alexc0888/Digital-Audio-Effects-Player/Project Schem.pdf

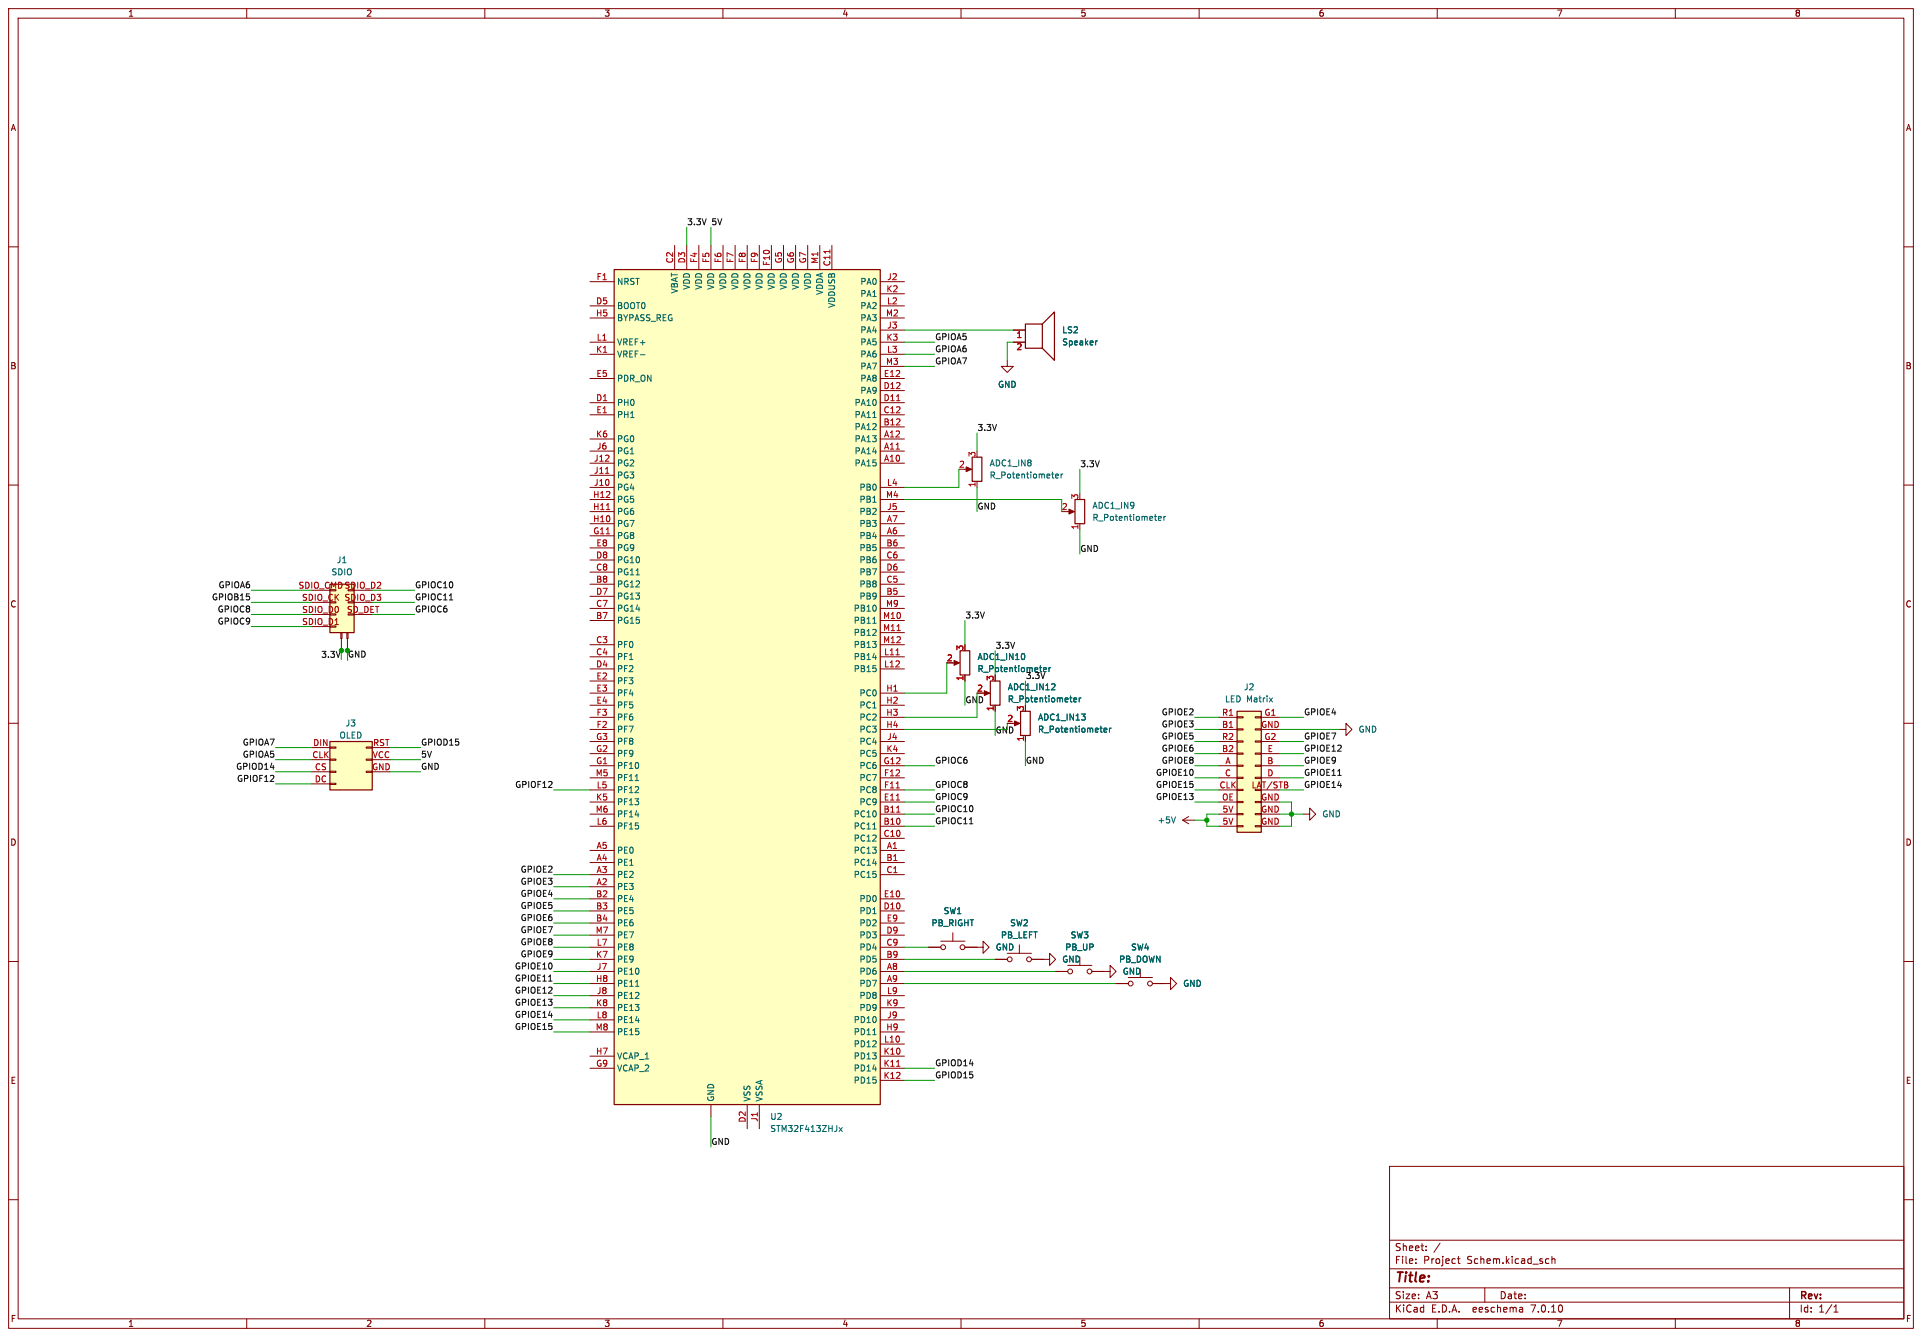
[picture p18: page 1]
