alexc0888/Digital-Audio-Effects-Player/Core/Src/main.c

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
/* Includes ------------------------------------------------------------------*/
#include "main.h"
#include "fatfs.h"

/* USER CODE BEGIN Includes */
#include <stdio.h>
/* USER CODE END Includes */

/* USER CODE BEGIN PD */
#define MAX_FILE_NAME_LEN _MAX_LFN + 1
/* USER CODE END PD */

ADC_HandleTypeDef hadc1;
DMA_HandleTypeDef hdma_adc1;

SD_HandleTypeDef hsd;
DMA_HandleTypeDef hdma_sdio_rx;
DMA_HandleTypeDef hdma_sdio_tx;

SPI_HandleTypeDef hspi1;

UART_HandleTypeDef huart3;

PCD_HandleTypeDef hpcd_USB_OTG_FS;

/* USER CODE BEGIN PV */
volatile int adcDone = TRUE;
volatile uint16_t adcSamples[5];
volatile knobs_t controlKnobs;
/* USER CODE END PV */

void SystemClock_Config(void);
static void MX_GPIO_Init(void);
static void MX_DMA_Init(void);
static void MX_USART3_UART_Init(void);
static void MX_USB_OTG_FS_PCD_Init(void);
static void MX_SDIO_SD_Init(void);
static void MX_SPI1_Init(void);
static void MX_ADC1_Init(void);
/* USER CODE BEGIN PFP */
#define PUTCHAR_PROTOTYPE int __io_putchar(int ch)
/* USER CODE END PFP */

/* USER CODE BEGIN 0 */
void HAL_ADC_ConvCpltCallback(ADC_HandleTypeDef *hadc)
{
	adcDone = TRUE;
	// standardize the potentiometer readings as a percentage
	controlKnobs.bassGain     = (float) adcSamples[0] / 4096.0f;
	controlKnobs.bassCutoff   = (float) adcSamples[1] / 4096.0f;
	controlKnobs.tremoloDepth = (float) adcSamples[2] / 4096.0f;
	controlKnobs.trebleGain   = (float) adcSamples[3] / 4096.0f;
	controlKnobs.trebleCutoff = (float) adcSamples[4] / 4096.0f;
}
void OLED_Reset(void) {
	HAL_GPIO_WritePin(OLED_RST_GPIO_Port, OLED_RST_Pin, GPIO_PIN_SET);
	HAL_Delay(100);
	HAL_GPIO_WritePin(OLED_RST_GPIO_Port, OLED_RST_Pin, GPIO_PIN_RESET);
	HAL_Delay(100);
	HAL_GPIO_WritePin(OLED_RST_GPIO_Port, OLED_RST_Pin, GPIO_PIN_SET);
	HAL_Delay(100);
}

void OLED_WriteReg(uint8_t Reg) {
	HAL_GPIO_WritePin(OLED_DC_GPIO_Port, OLED_DC_Pin, GPIO_PIN_RESET);
	HAL_GPIO_WritePin(OLED_CS_GPIO_Port, OLED_CS_Pin, GPIO_PIN_RESET);
	HAL_SPI_Transmit(&hspi1, &Reg, 1, 1000);
	HAL_GPIO_WritePin(OLED_CS_GPIO_Port, OLED_CS_Pin, GPIO_PIN_SET);
}

void OLED_WriteData(uint8_t Reg) {
	HAL_GPIO_WritePin(OLED_DC_GPIO_Port, OLED_DC_Pin, GPIO_PIN_SET);
	HAL_GPIO_WritePin(OLED_CS_GPIO_Port, OLED_CS_Pin, GPIO_PIN_RESET);
	HAL_SPI_Transmit(&hspi1, &Reg, 1, 1000);
	HAL_GPIO_WritePin(OLED_CS_GPIO_Port, OLED_CS_Pin, GPIO_PIN_SET);
}

void OLED_StartWrite() {
	HAL_GPIO_WritePin(OLED_DC_GPIO_Port, OLED_DC_Pin, GPIO_PIN_SET);
	HAL_GPIO_WritePin(OLED_CS_GPIO_Port, OLED_CS_Pin, GPIO_PIN_RESET);
}

void OLED_WriteSeq(uint8_t *data, int len) {
	HAL_SPI_Transmit(&hspi1, data, len, 10000);
}

void OLED_EndWrite() {
	HAL_GPIO_WritePin(OLED_CS_GPIO_Port, OLED_CS_Pin, GPIO_PIN_SET);
}

char listState(char **listToDisp, int numItems, char *header, int *cursor)
{
	*cursor = 0; // clear out the cursor for next render
	char input = 'X';
	char *list[MAX_LIST_PER_MENU]; // we can only display 7 items per menu, so lets fit our list down to this

	for(int item = 0; item < MAX_LIST_PER_MENU; item++)
	{
		list[item] = "\0";
	}
	for(int item = 0; (item < MAX_LIST_PER_MENU) && (item < numItems); item++)
	{
		list[item] = listToDisp[item];
	}

	do
	{
		input = getButton();

		*cursor += (input == 'D') ? 1  :
							(input == 'U') ? -1 : 0;
		if(*cursor < 0)
		{
			*cursor = numItems - 1;
		}
		if(*cursor > numItems - 1)
		{
			*cursor = 0;
		}
		render_list(*cursor, header, list, numItems);
	} while(input != 'R' && input != 'L');

	return input;
}

void playTrackState(int songSelection, char *songName)
{
  // Initialize important variables for playing song
  int songPlaying = TRUE;
  wav_header_t songInfo;
  int sd_status;
  int16_t songBuffer[SONG_BUFF_SIZE]; // .wav file encoded in pcm_s16le
  float   songBufferFlt[SONG_BUFF_SIZE];
  color_t fftFrame [ROW][COL];
  unsigned int bytesRead;
  int currentByte = 0;
  uint32_t cycle = 0;
	char input = 'X';
	adcDone = TRUE;

	// Load up the song and parse the header of the .WAV file
  if(sdLoadSong(songName) != SD_SUCCESS)
  {
  	Error_Handler();
  }
  if(parseWavHeader(&songInfo) != SD_SUCCESS)
  {
  	Error_Handler();
  }
	int totalDuration = songInfo.Subchunk2Size / AUDIO_SAMPLE_RATE;
	int currTime      = 0;

  while(songPlaying)
  {
  	if(adcDone == TRUE)
  	{
  		// start up another ADC transaction to get the next audioParams inside controlKnobs
  		adcDone = FALSE;
  		HAL_ADC_Start_DMA(&hadc1, (uint32_t *) adcSamples, 5);
  	}
  	sd_status = sdReadSong(songBuffer, &bytesRead);
    if(sd_status == SD_FAIL)
    {
    	Error_Handler();
    }
    else if(sd_status == SD_EOF) // fetched last bit of the song, it will end after this iteration
    {
    	songPlaying = FALSE;
    }

    // Render a new "track playing" frame onto the OLED
    // The SPI transactions to the OLED is not done via DMA, so drawing the screen is awfully slow
    // We will only refresh the screen at very infrequent intervals so that audio lag can be mostly avoided
    currentByte += bytesRead;
    if(cycle == 0)
    {
    	currTime = ((double) currentByte / (double) songInfo.Subchunk2Size) * (double) totalDuration;
      render_track_playing(songName, currTime, totalDuration);
    }
    cycle++;
    if(cycle == 1000)
    {
    	cycle = 0;
    }

    input = getButton();
    if(input == 'L')
    {
    	songPlaying = FALSE;
    }


    // create a floating point buffer of the sample for data processing + FFT
    convS16Float(songBuffer, songBufferFlt, TRUE);

    // Perform audio processing algorithms on songBufferFlt...
    applyAudioEffects(songBufferFlt, SONG_BUFF_SIZE, controlKnobs);

    /* Note that the FFT drawing on the screen will be ever so slightly
     * ahead of the audio playback from the DAC. The reason for this is
     * because we have a producer-consumer situation with the audio samples going into the DAC
     * (producer is CPU calling fillDacBuffer which adds a set of samples to the DACBufferQ, while
     * the consumer is the DMA which pops from the DACBufferQ. This allows for maximum flexibility
     * by ensuring two things:
     * 1). The DMA will always have new audio to playback at the specified 44.1 KHz playback frequency
     * 2). The CPU will not be blocked if the DMA is running behind on DMA playback. The CPU can simply
     *     add the next set of samples to the DACBufferQ and move on to reading the next set of samples
     *     from the SD Card.
     *
     * However, there is no producer-consumer situation set up for drawing the FFT to the LED matrix. Doing
     * so combined with the interpolation would result in far too much memory usage. If we weren't limited to a relatively
     * small set of memory, then we could more tightly synchronize the screen and audio. That being said, the desync is
     * hardly noticeable (on the scale of milliseconds) so it really doesn't present a problem.
     * */

    // Compute FFT and draw frames
    // Step 1: Create and store first frame
    computeFFTScreen(songBufferFlt, SONG_BUFF_SIZE, fftFrame);
    storeFrame(fftFrame);
    // Step 2: Generate interpolated frames and display them
    for(int step = 0; step < INTERP_STEPS; step++)
    {
      // Calculate interpolation factor (0.0 to 1.0)
      float factor = (float)step / (float)(INTERP_STEPS - 1);
      // Draw the interpolated frame
      drawInterpFrame(factor);
    }

    // Producer - push the latest set of samples onto the DACBufferQ
    fillDacBuffer(songBufferFlt);
  }
  sdCloseFile();

}


/* USER CODE END 0 */

/**
  * @brief  The application entry point.
  * @retval int
  */
int main(void)
{

  /* MCU Configuration--------------------------------------------------------*/

  /* Reset of all peripherals, Initializes the Flash interface and the Systick. */
  HAL_Init();

  /* Configure the system clock */
  SystemClock_Config();

  /* Initialize all configured peripherals */
  MX_GPIO_Init();
  MX_DMA_Init();
  MX_USART3_UART_Init();
  MX_USB_OTG_FS_PCD_Init();
  MX_SDIO_SD_Init();
  MX_FATFS_Init();
  MX_SPI1_Init();
  MX_ADC1_Init();
  /* USER CODE BEGIN 2 */
  // Check SD card details
  DEBUG_PRINTF("\n\rSD Card Information:\r\n");
  DEBUG_PRINTF("Block size         : %lu\r\n", hsd.SdCard.BlockSize);
  DEBUG_PRINTF("Block number       : %lu\r\n", hsd.SdCard.BlockNbr);

  // Try mounting the card...
  if(sdMount() != SD_SUCCESS)
  {
    Error_Handler();
  }

  // point back into the songList array with songPtrs
  // I am doing this so that I can pass these parameters into
  // functions that accept generic char ** args
  char songList[MAX_FILE_NUM][MAX_FILE_NAME_LEN];
  char *songPtrs[MAX_FILE_NUM];
  for(int i = 0; i < MAX_FILE_NUM; i++)
  {
  	songPtrs[i] = songList[i];
  }
  int numSongs;
  char *optionList[3] = {"Bass Boost", "Tremolo Filter", "Treble Boost"};
  char *yesNoList[2] = {"Yes", "No"};
	int selection;
	int currOption;
	state_t oledState = TRACK_LIST_STATE; // always turn on machine with this state
	state_t nextState = oledState;
	char stateInput;

  // grab a list of all the songs currently on-file in the SD card
  if(sdGetFileList(songPtrs, SONG_DIR, &numSongs) != SD_SUCCESS)
  {
  	Error_Handler();
  }
  DEBUG_PRINTF("Printing all the found songs: \r\n");
  for(int i = 0; i < numSongs; i++)
  {
  	DEBUG_PRINTF("%s\r\n", songPtrs[i]);
  }
	// Reset the OLED
  OLED_Reset();
  OLED_InitReg();
  OLED_1in5_rgb_Init();


  while(1)
  {

  	if(oledState == TRACK_LIST_STATE)
  	{
  		stateInput = listState(songPtrs, numSongs, "Track Selection", &selection);
  		nextState = (stateInput == 'R') ? TRACK_PLAYING_STATE : OPTIONS_LIST_STATE;
  	}
  	else if(oledState == OPTIONS_LIST_STATE)
  	{
  		stateInput = listState(optionList, sizeof(optionList) / sizeof(char *), "Options", &selection);
  		currOption = selection; // preserve the current selected option for future use
  		nextState = (stateInput == 'R') ? TRACK_LIST_STATE : YES_NO_LIST_STATE;
  	}
  	else if(oledState == YES_NO_LIST_STATE)
  	{
  		stateInput = listState(yesNoList, sizeof(yesNoList) / sizeof(char *), optionList[currOption], &selection);
  		nextState = OPTIONS_LIST_STATE;
  		if(currOption == 0)
  		{
  			TDsrBassBoost(!selection);
  		}
  		else if(currOption == 1)
  		{
  			TDsrTremoloFilter(!selection);
  		}
  		else if(currOption == 1)
  		{
  			TDsrTrebleBoost(!selection);
  		}
  	}
  	else if(oledState == TRACK_PLAYING_STATE)
  	{
      // Initiate hardware for playing music
    	initMatrix();
    	initFrameBuffers();
    	initDAC();
      playTrackState(selection, songList[selection]);
      // reset DAC and matrix to stop audio and visual playback
      initMatrix();
      initFrameBuffers();
      initDAC();
      nextState = TRACK_LIST_STATE;
  	}
  	oledState = nextState;
  }


	// Reset the OLED
  OLED_Reset();
  if(sdUnmount() != SD_SUCCESS)
  {
  	Error_Handler();
  }


  /* USER CODE END 2 */

  /* Infinite loop */
  /* USER CODE BEGIN WHILE */
  while (1)
  {
    /* USER CODE END WHILE */

    /* USER CODE BEGIN 3 */

  }
  /* USER CODE END 3 */
}

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
/* USER CODE BEGIN 4 */

/**
  * @brief  Retargets the C library printf function to the USART.
  *   None
  * @retval None
  */
PUTCHAR_PROTOTYPE
{
  /* Place your implementation of fputc here */
  /* e.g. write a character to the USART3 and Loop until the end of transmission */
  HAL_UART_Transmit(&huart3, (uint8_t *)&ch, 1, 0xFFFF);

  return ch;
}

/* USER CODE END 4 */
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
