alexc0888/Digital-Audio-Effects-Player/Digital-Audio-Effects-Player.ioc

Mcu.UserName=STM32F413ZHTx
PA10.GPIO_Label=USB_ID
PA10.Signal=USB_OTG_FS_ID
PA11.GPIO_Label=USB_DM
PA11.Signal=USB_OTG_FS_DM
PA12.GPIO_Label=USB_DP
PA12.Signal=USB_OTG_FS_DP
PA13.GPIO_Label=TMS
PA13.Signal=SYS_JTMS-SWDIO
PA14.GPIO_Label=TCK
PA14.Signal=SYS_JTCK-SWCLK
PA5.Signal=SPI1_SCK
PA6.Signal=SDIO_CMD
PA7.Signal=SPI1_MOSI
PA8.GPIO_Label=USB_SOF [TP1]
PA8.Signal=USB_OTG_FS_SOF
PA9.GPIO_Label=USB_VBUS
PA9.Signal=USB_OTG_FS_VBUS
PB0.Signal=ADCx_IN8
PB1.Signal=ADCx_IN9
PB14.GPIO_Label=LD3 [Red]
PB14.Signal=GPIO_Output
PB15.Signal=SDIO_CK
PB3.GPIO_Label=SWO
PB3.Signal=SYS_JTDO-SWO
PB4.Signal=SPI1_MISO
PB7.GPIO_Label=LD2 [Blue]
PB7.Signal=GPIO_Output
PC0.Signal=ADCx_IN10
PC10.Signal=SDIO_D2
PC11.Signal=SDIO_D3
PC13.GPIO_Label=USER_Btn [B1]
PC13.Signal=GPXTI13
PC14-OSC32_IN.Signal=RCC_OSC32_IN
PC15-OSC32_OUT.Signal=RCC_OSC32_OUT
PC2.Signal=ADCx_IN12
PC3.Signal=ADCx_IN13
PC6.GPIO_Label=SD_DET
PC6.Signal=GPIO_Input
PC8.Signal=SDIO_D0
PC9.Signal=SDIO_D1
PD14.GPIO_Label=OLED_CS
PD14.Signal=GPIO_Output
PD15.GPIO_Label=OLED_RST
PD15.Signal=GPIO_Output
PD4.GPIO_Label=PB_RIGHT
PD4.Signal=GPXTI4
PD5.GPIO_Label=PB_LEFT
PD5.Signal=GPXTI5
PD6.GPIO_Label=PB_UP
PD6.Signal=GPXTI6
PD7.GPIO_Label=PB_DOWN
PD7.Signal=GPXTI7
PD8.GPIO_Label=STLK_RX [STM32F103CBT6_PA3]
PD8.Signal=USART3_TX
PD9.GPIO_Label=STLK_TX [STM32F103CBT6_PA2]
PD9.Signal=USART3_RX
PF12.GPIO_Label=OLED_DC
PF12.Signal=GPIO_Output
PG6.GPIO_Label=USB_PowerSwitchOn
PG6.Signal=GPIO_Output
PG7.GPIO_Label=USB_OverCurrent
PG7.Signal=GPIO_Input
