alexc0888/Digital-Audio-Effects-Player/Core/Inc/main.h

#define USER_Btn_Pin GPIO_PIN_13
#define USER_Btn_GPIO_Port GPIOC
#define MCO_Pin GPIO_PIN_0
#define MCO_GPIO_Port GPIOH
#define OLED_DC_Pin GPIO_PIN_12
#define OLED_DC_GPIO_Port GPIOF
#define LD3_Pin GPIO_PIN_14
#define LD3_GPIO_Port GPIOB
#define STLK_RX_Pin GPIO_PIN_8
#define STLK_RX_GPIO_Port GPIOD
#define STLK_TX_Pin GPIO_PIN_9
#define STLK_TX_GPIO_Port GPIOD
#define OLED_CS_Pin GPIO_PIN_14
#define OLED_CS_GPIO_Port GPIOD
#define OLED_RST_Pin GPIO_PIN_15
#define OLED_RST_GPIO_Port GPIOD
#define USB_PowerSwitchOn_Pin GPIO_PIN_6
#define USB_PowerSwitchOn_GPIO_Port GPIOG
#define USB_OverCurrent_Pin GPIO_PIN_7
#define USB_OverCurrent_GPIO_Port GPIOG
#define SD_DET_Pin GPIO_PIN_6
#define SD_DET_GPIO_Port GPIOC
#define USB_SOF_Pin GPIO_PIN_8
#define USB_SOF_GPIO_Port GPIOA
#define USB_VBUS_Pin GPIO_PIN_9
#define USB_VBUS_GPIO_Port GPIOA
#define USB_ID_Pin GPIO_PIN_10
#define USB_ID_GPIO_Port GPIOA
#define USB_DM_Pin GPIO_PIN_11
#define USB_DM_GPIO_Port GPIOA
#define USB_DP_Pin GPIO_PIN_12
#define USB_DP_GPIO_Port GPIOA
#define TMS_Pin GPIO_PIN_13
#define TMS_GPIO_Port GPIOA
#define TCK_Pin GPIO_PIN_14
#define TCK_GPIO_Port GPIOA
#define PB_RIGHT_Pin GPIO_PIN_4
#define PB_RIGHT_GPIO_Port GPIOD
#define PB_RIGHT_EXTI_IRQn EXTI4_IRQn
#define PB_LEFT_Pin GPIO_PIN_5
#define PB_LEFT_GPIO_Port GPIOD
#define PB_LEFT_EXTI_IRQn EXTI9_5_IRQn
#define PB_UP_Pin GPIO_PIN_6
#define PB_UP_GPIO_Port GPIOD
#define PB_UP_EXTI_IRQn EXTI9_5_IRQn
#define PB_DOWN_Pin GPIO_PIN_7
#define PB_DOWN_GPIO_Port GPIOD
#define PB_DOWN_EXTI_IRQn EXTI9_5_IRQn
#define SWO_Pin GPIO_PIN_3
#define SWO_GPIO_Port GPIOB
#define LD2_Pin GPIO_PIN_7
#define LD2_GPIO_Port GPIOB
