alexc0888/Digital-Audio-Effects-Player/Core/Inc/fft_driver.h

/*
 * fft_driver.h
 *
 *  Created on: Mar 25, 2025
 *      Author: alexc0888     (Alex Chitsazzadeh)
 *      				derekxrosales (Derek Rosales
 */

#ifndef __FFT_DRIVER__
#define __FFT_DRIVER__

#define ARM_MATH_CM4 // define Cortex M4 for arm_math.h

#include <math.h>
#include "stm32f413xx.h"
#include "arm_math.h"
#include "matrix_driver.h"
#include "shared_consts.h"

// Defined constants

// strange things happen if we don't cast this define to an int
#define BIN_WIDTH_SCREEN (int) (COL / (FFT_SCREEN_LEN / 2)) // the amount of pixel columns taken up per bin on screen

// Function declarations
void initFFT(uint16_t);
void computeFFT(float *, uint16_t, uint16_t, float *, float *, float *);
void computeIFFT(float *, uint16_t, uint16_t, float *, float *);


#endif
