alexc0888/Digital-Audio-Effects-Player/Core/Inc/my_sdcard.h

/*
 * my_sdcard.h
 *
 *  Created on: Apr 5, 2025
 *      Authors: alexc0888  (Alex Chitsazzadeh)
 *      				 itsadisood (Aditya Sood)
 */

#ifndef __MY_SDCARD__
#define __MY_SDCARD__

#include "shared_consts.h"
#include <string.h>

// SD Card related definitions
#define SD_EOF     0x2
#define SD_SUCCESS 0x1
#define SD_FAIL    0x0
#define ROOT_DIR   "0:/"
#define SONG_DIR   "0:/Songs"
#define MAX_FILE_NUM 64 // maximum files allowed in a given directory (due to statically allocated arrays)
#define MAX_PATH_LEN 256 + 1 // include an extra byte for the '/' to append file to pathname
#define SD_BLOCK_SIZE 512

// Wrapper functions for fatFS
int sdMount();
int sdOpenFile(char *);
int sdReadFile(void *, uint32_t, unsigned int *);
int sdCloseFile();
int sdUnmount();

// Custom functions for
int sdGetFileList(char **, char *, int *);
int sdLoadSong(char *);
int sdReadSong(int16_t [SONG_BUFF_SIZE], unsigned int *);


#endif
