alexc0888/Digital-Audio-Effects-Player/Core/Inc/shared_consts.h

/*
 * shared_consts.h
 *
 *  Created on: Apr 12, 2025
 *      Author: alexc0888 (Alex Chitsazzadeh)
 */

#ifndef __SHARED_CONSTS__
#define __SHARED_CONSTS__

#include <stdio.h>
#include "stm32f4xx_hal.h"

typedef struct
{
	float bassGain;
	float bassCutoff;

	float tremoloDepth;

	float trebleGain;
	float trebleCutoff;
} knobs_t;

#define MAX_VAL_UINT16_T 0xffff
#define MAX_VAL_INT16_T  0x7fff
#define AUDIO_SAMPLE_RATE 44100
#define MAX_AMPLITUDE 3.3f
#define SONG_BUFF_SIZE 2048 / (sizeof(int16_t))

#define TRUE 0x1
#define FALSE 0x0

// Defined constants
#define FFT_SCREEN_LEN 32
#define FFT_AUDIO_LEN  64
#define FFT_MAX_LEN    64

#define DEBUG_MODE

#ifdef DEBUG_MODE
#define DEBUG_PRINTF printf
#else
#define DEBUG_PRINTF(...)
#endif

#endif
