alexc0888/Digital-Audio-Effects-Player/(commit log)

2025-03-20 Initial commit for project. Have basic drivers for led matrix.
2025-03-22 Broken implementation of DMA driver for LED matrix
    [main.c, matrix_driver.c, matrix_driver.h]
2025-03-22 DMA is now working to automatically draw screen on LED matrix display
2025-03-24 Finalized matrix driver to draw incoming frame from abstracted frame data structure to lower-level screen data structure
2025-03-25 LED matrix is completed. Implemented FFT from arm_fft library and tested the frequency spectrum on the LED matrix by drawing FFT for two different sin wave tables.
2025-03-31 Finished prototyping DAC. The LM386 Amplifier circuit is having some issues at the moment though.
    [dac_output.c, dac_output.h, main.c, main.h, matrix_driver.c, matrix_driver.h]
2025-04-05 Alex: Implemented more functions in my_sdcard.c. Also sucessfully parsed the header for a .wav file and have all the relevant metadata saved. Ready to start streaming the audio samples now.
2025-04-11 Fixed some defined parameter usage
    [dac_output.c, main.c, my_sdcard.h]
2025-04-14 Alex: Implemented double buffering DMA peripheral for DAC. Audio is now perfectly smooth with no crackle/cuts. CPU is also no longer blocked by DMA transaction to DAC being finished since a 16-depth 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
    [circular_buffer.c, circular_buffer.h, dac_output.c, dac_output.h, main.c]
2025-04-15 dxrosales: syntax and bug fixes
    [fft_driver.c, fft_driver.h, main.c, main.h, shared_consts.h]
2025-04-21 Alex: Fixed a bunch of bugs with the bass boost. Unfortunately, our FFT approach will not work since we cannot handle larger FFT lengths like 1024, yet our sample sizes must be large each iteration i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
    [audio_processing.c, audio_processing.h, fft_driver.c, fft_driver.h, main.c, main.h, matrix_driver.c, matrix_driver.h]
2025-04-21 alexc0888: Integrated Vinay's OLED driver code into main project. Cleaned up some includes in various files and added miscellaneous header information. Deleted old files that we don't need anymore, l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
2025-04-21 dxrosales:
    Added support for lowpass filtering in Time Domain for bass boost, as
    opposed to the previously implemented Frequency Domain Filtering
2025-04-21 alexc0888: Set track list in oled_driver based on contents of SD card
2025-04-22 alexc0888: Implemented button control as well as debouncing schemes. Started to structure how the main function will look so this project can function as a continuous loop controlled by the user.
2025-04-25 alexc0888: Added overall volume control and tremolo filter to audio_processing.c/.h Also started testing the OLED 'now_playing' track screen. Its causing a lot of lag in the audio right now, because 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
2025-04-25 alexc0888: Reverted some temp changes.
    [main.c, oled_driver.c, oled_driver.h]
2025-04-25 alexc0888: Added a new screen to show on the OLED for when a song ends or a user quits a song early. A choice is given as to whether the user wants to listen to another song or to shut off the device.
2025-04-25 alexc0888: Restructured reset and initialization of device drivers to make user experience feel more seamless.
    [dac_output.c, main.c, matrix_driver.c]
2025-04-25 alexc0888: Implemented ADC for sampling input controls.
2025-04-26 alexc0888: added the rest of the ADC potentiometers for additional knobs, and implemented DMA on ADC to stop the CPU from being blocked on every ADC transaction.
2025-08-10 Added project schematic
